vasiaplaton/BecomeHuman/hardware/old_versions/PCB_PCB_2020-02-24 16_39_55_20200224180347.pdf

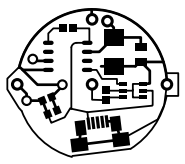
[picture p9: figure]
