vasiaplaton/BecomeHuman/hardware/Round pcb.jpg

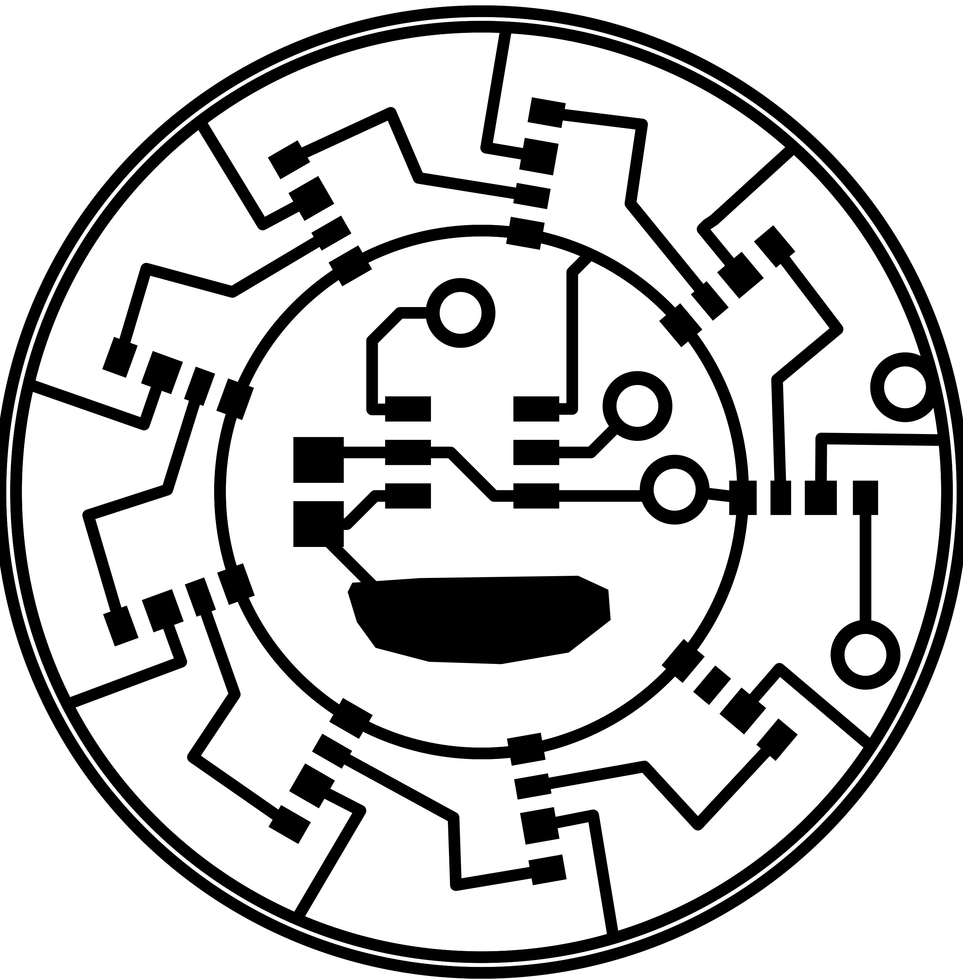
hardware/Round pcb.jpg
