vasiaplaton/BecomeHuman/img/devicepicker.jpg

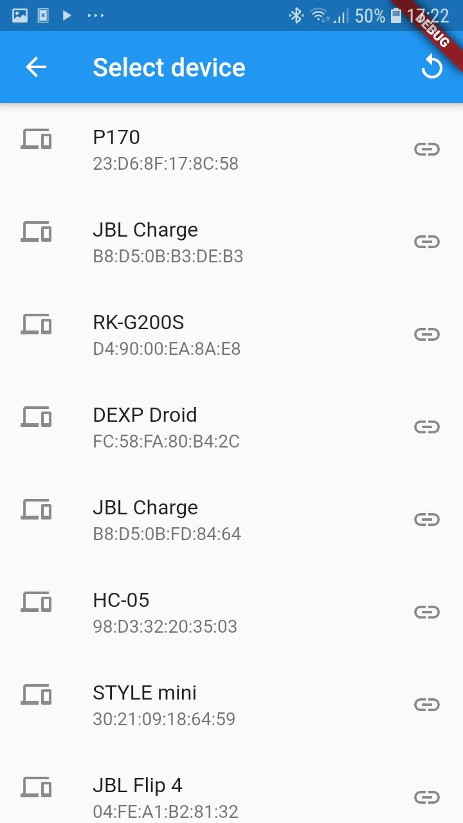
img/devicepicker.jpg
