vasiaplaton/BecomeHuman/img/snap_video2.png

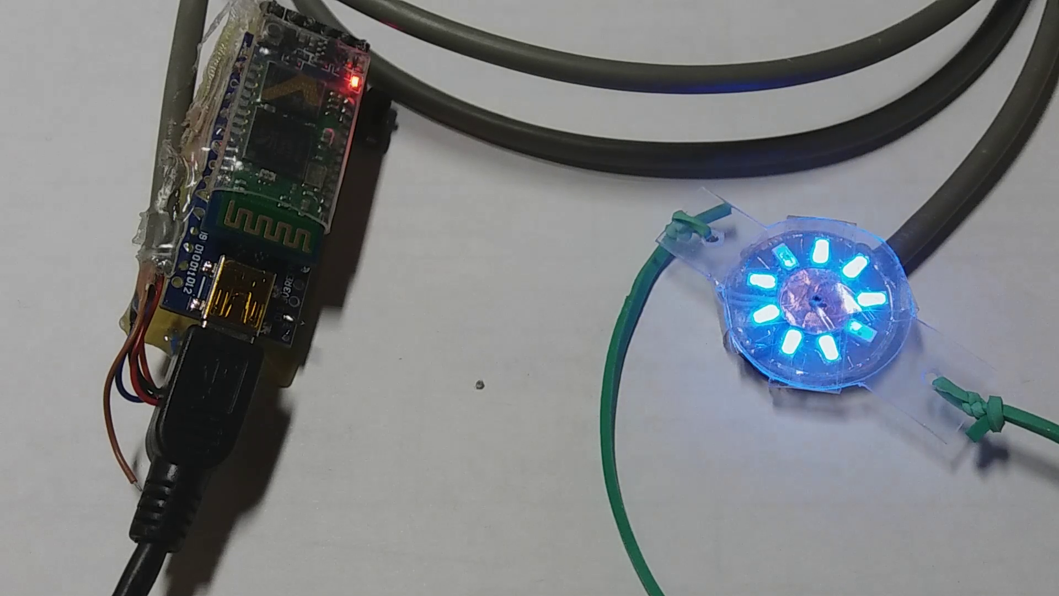
img/snap_video2.png
