vasiaplaton/BecomeHuman/img/snap_video.png

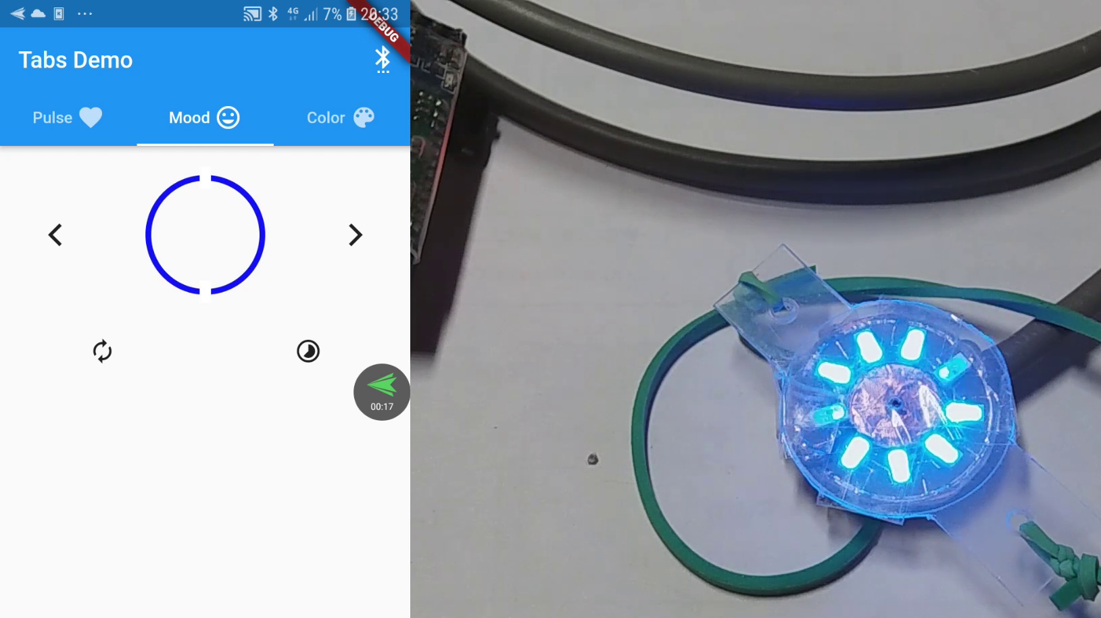
img/snap_video.png
