vasiaplaton/BecomeHuman/hardware/schematic/Schematic_Become_human_arduino_2020-05-31_11-42-52.pdf

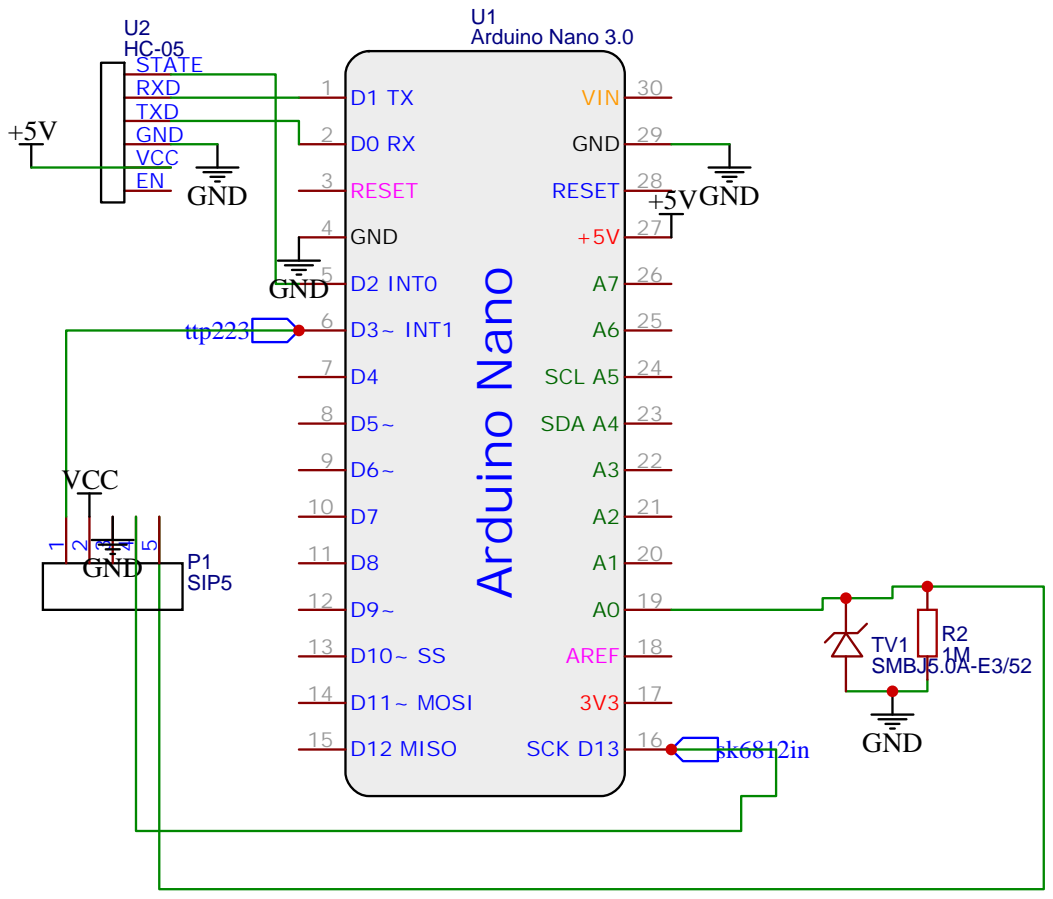
[picture p14: page 1]

Drawn By: vasia.platon
