vasiaplaton/BecomeHuman/hardware/old_versions/PCB_main1_20200224152810.pdf

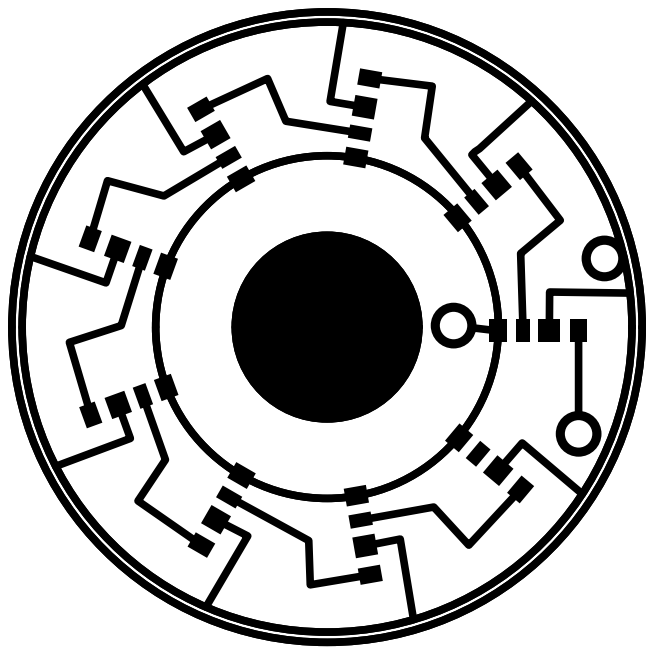
[picture p15: page 1]
