vasiaplaton/BecomeHuman/hardware/old_versions/PCB_main1_20200318115548.pdf

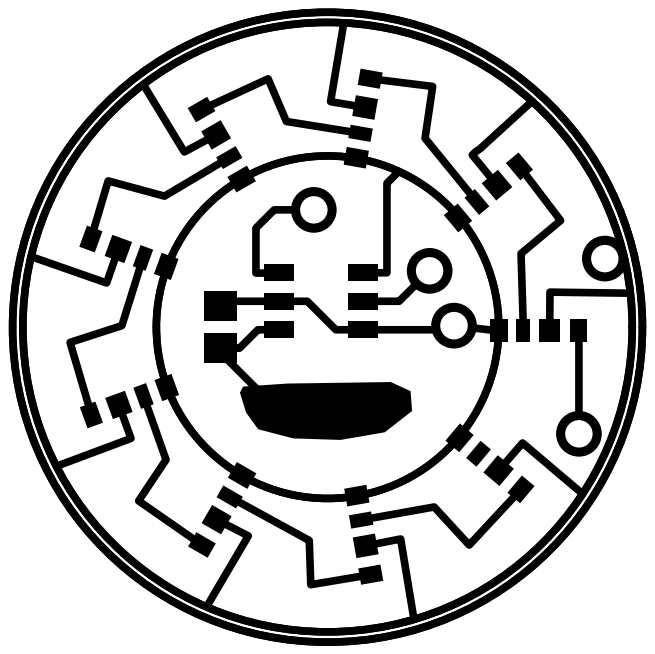
[picture p16: page 1]
