vasiaplaton/BecomeHuman/hardware/old_versions/PCB_PCB_2020-03-18 12_56_10_20200318132341.pdf

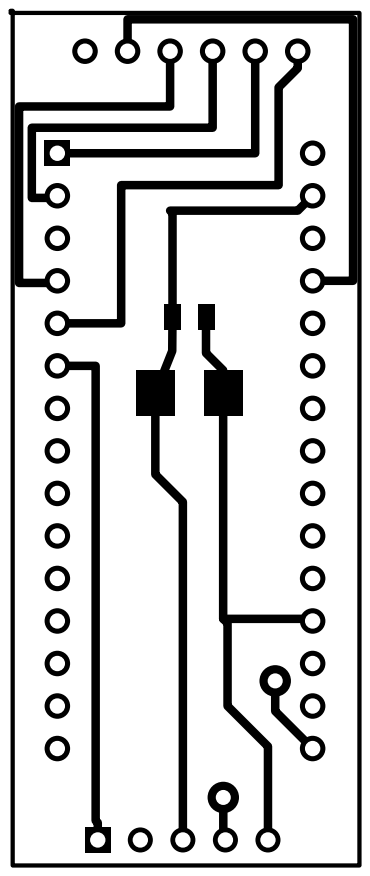
[picture p17: page 1]
