vasiaplaton/BecomeHuman/hardware/old_versions/PCB_PCB_2020-03-18 12_56_10_20200318135543.pdf

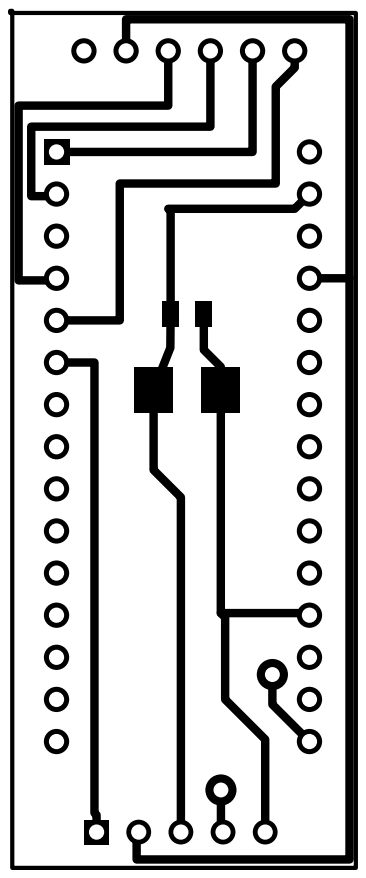
[picture p18: page 1]
