vasiaplaton/BecomeHuman/hardware/old_versions/PCB_test_20200221211556.pdf

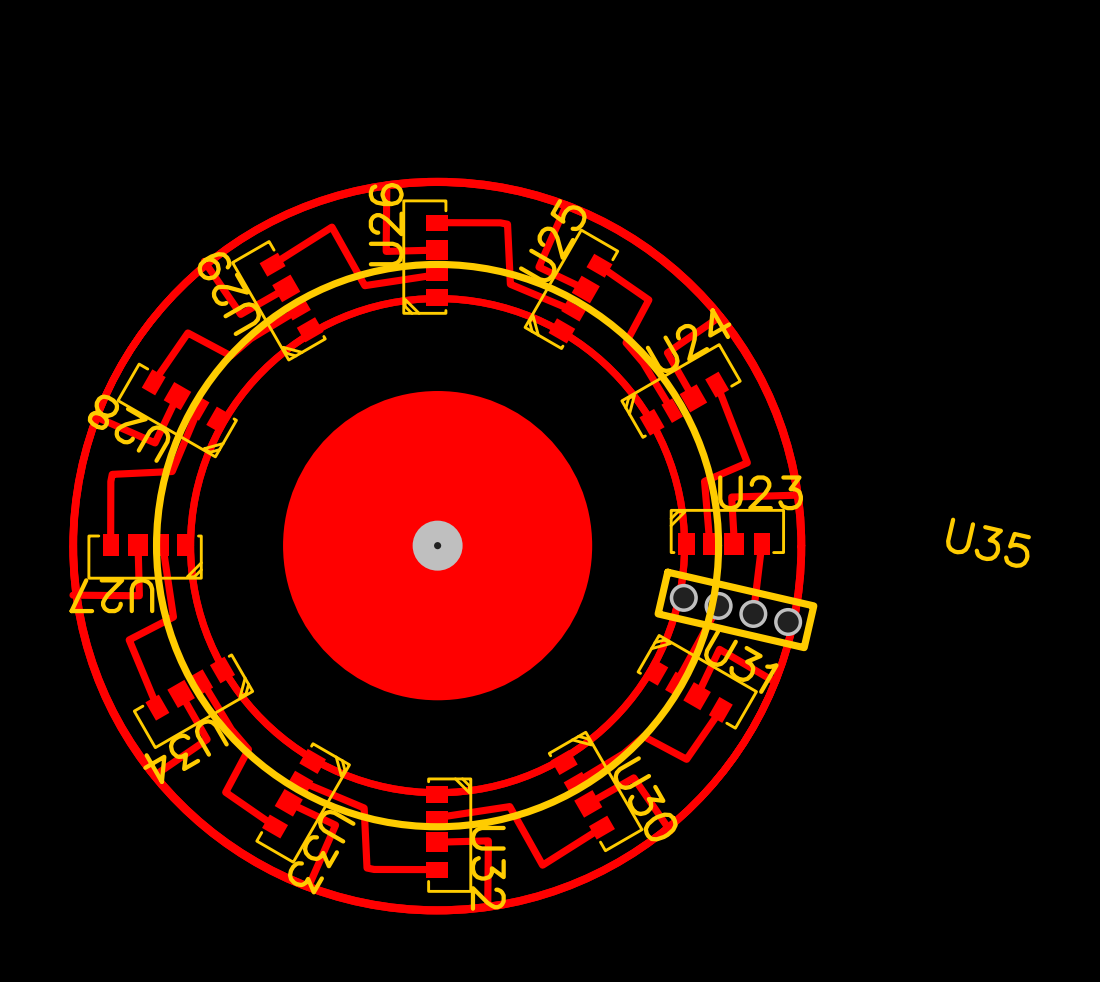
[picture p19: page 1]
