vasiaplaton/BecomeHuman/hardware/old_versions/PCB_test_20200223201018.pdf

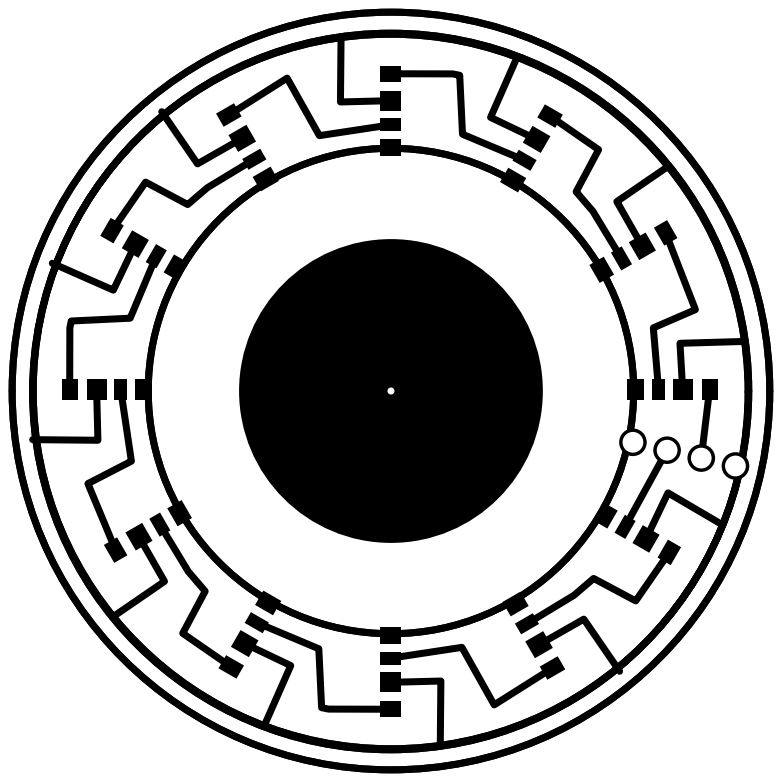
[picture p20: page 1]
