vasiaplaton/BecomeHuman/hardware/old_versions/PCB_test_20200224120651.pdf

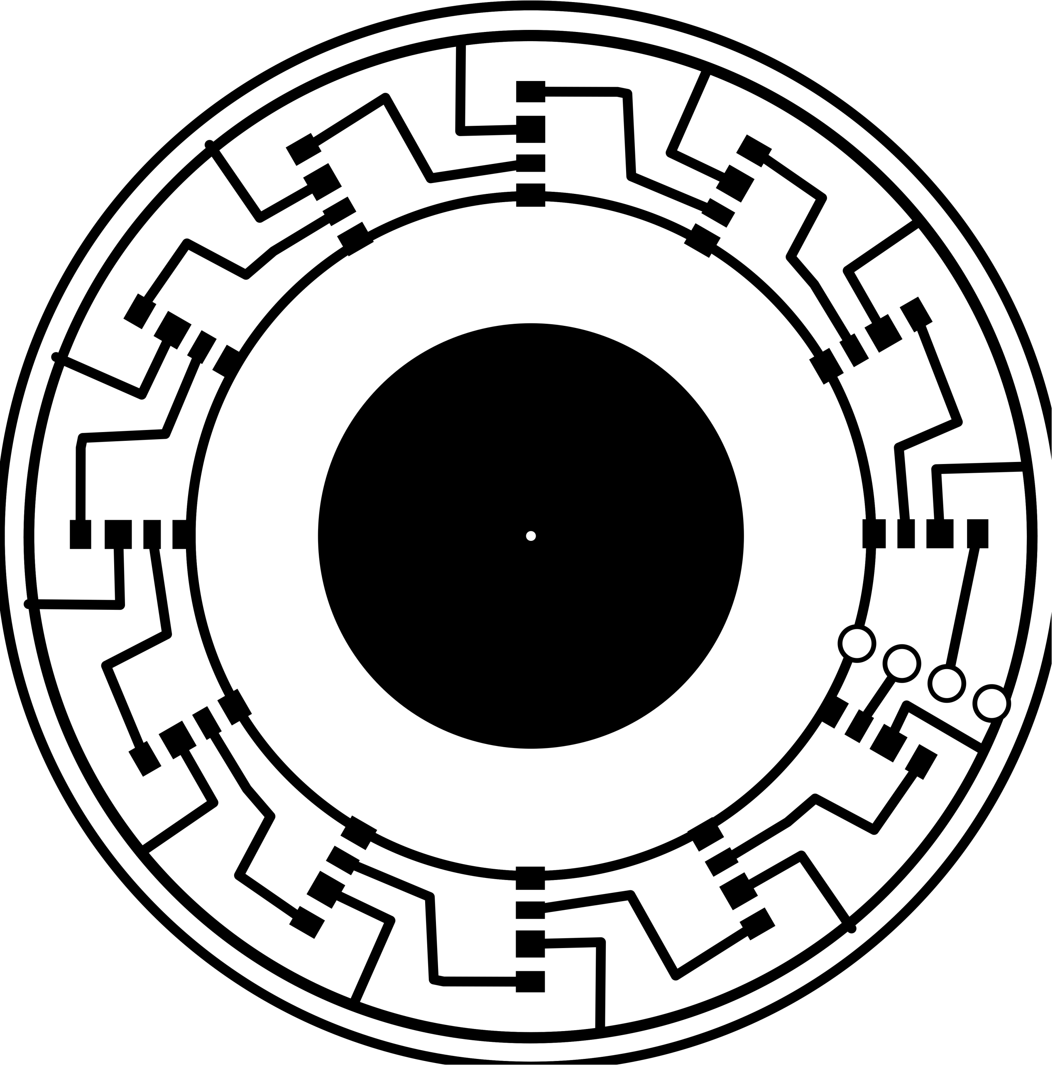
[picture p21: page 1]
